EaindrayFromEarth/STM32-diffdrive-base/DC_Motor_Control.ioc

Mcu.UserName=STM32F407VGTx
PA0-WKUP.Signal=S_TIM2_CH1_ETR
PA1.Signal=S_TIM2_CH2
PA11.Signal=USB_OTG_FS_DM
PA12.Signal=USB_OTG_FS_DP
PA13.Signal=SYS_JTMS-SWDIO
PA14.Signal=SYS_JTCK-SWCLK
PA3.Signal=GPIO_Input
PA5.Signal=ADCx_IN5
PA6.Signal=S_TIM3_CH1
PA7.Signal=S_TIM3_CH2
PA9.Signal=USB_OTG_FS_VBUS
PB6.Signal=I2C1_SCL
PB7.Signal=I2C1_SDA
PD12.Signal=S_TIM4_CH1
PD13.Signal=GPIO_Output
PD14.Signal=GPIO_Output
PE0.Signal=GPIO_Output
PE1.Signal=GPIO_Output
PE5.Signal=S_TIM9_CH1
PH0-OSC_IN.Signal=RCC_OSC_IN
PH1-OSC_OUT.Signal=RCC_OSC_OUT
